chncaesar/stm32_vehicle/docs/L298N驱动板功能图.jpg

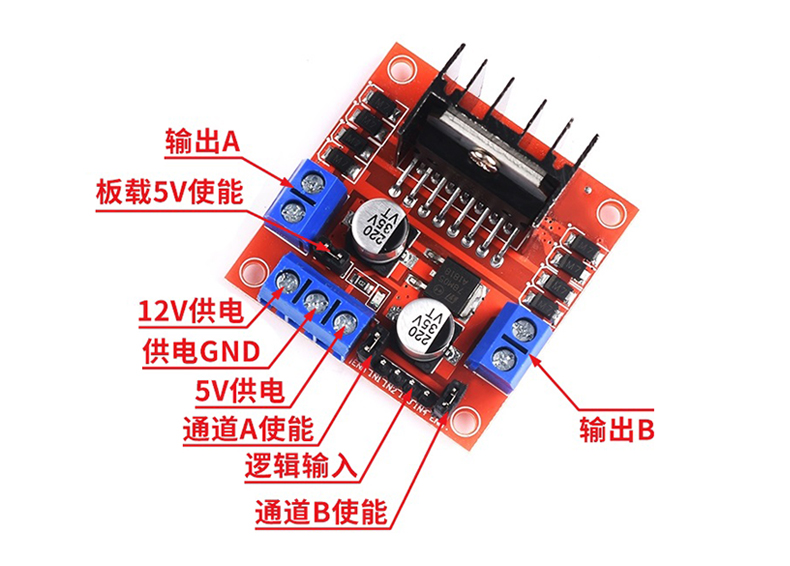
docs/L298N驱动板功能图.jpg
