chncaesar/stm32_vehicle/docs/ch340g.jpg

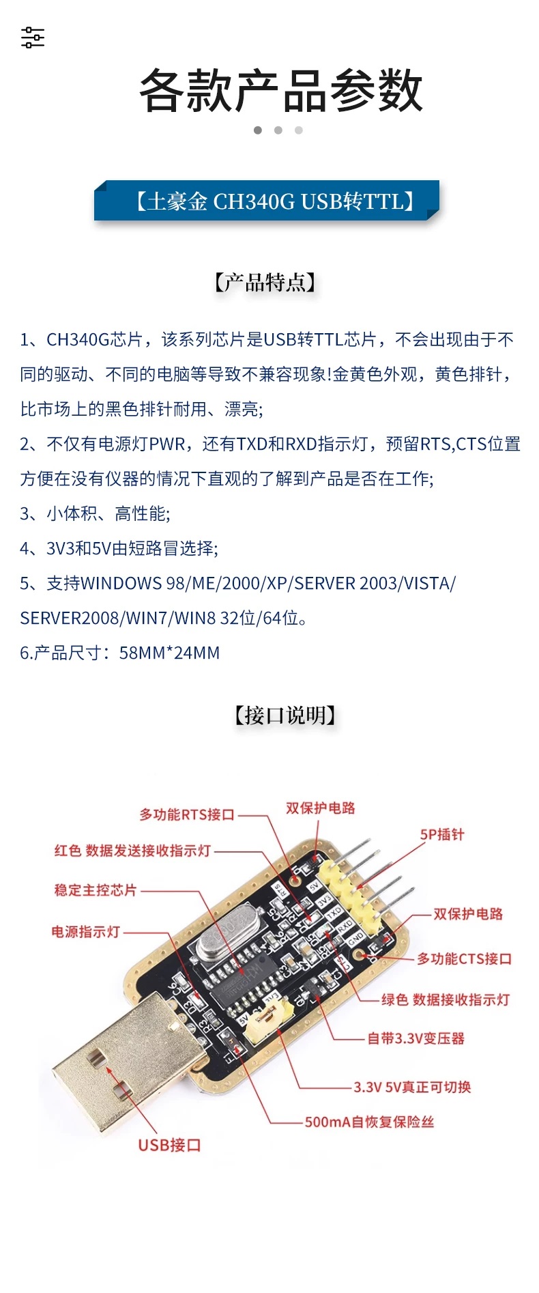
docs/ch340g.jpg
