chncaesar/stm32_vehicle/docs/STM32F103RCT6控制板1-PCB.png

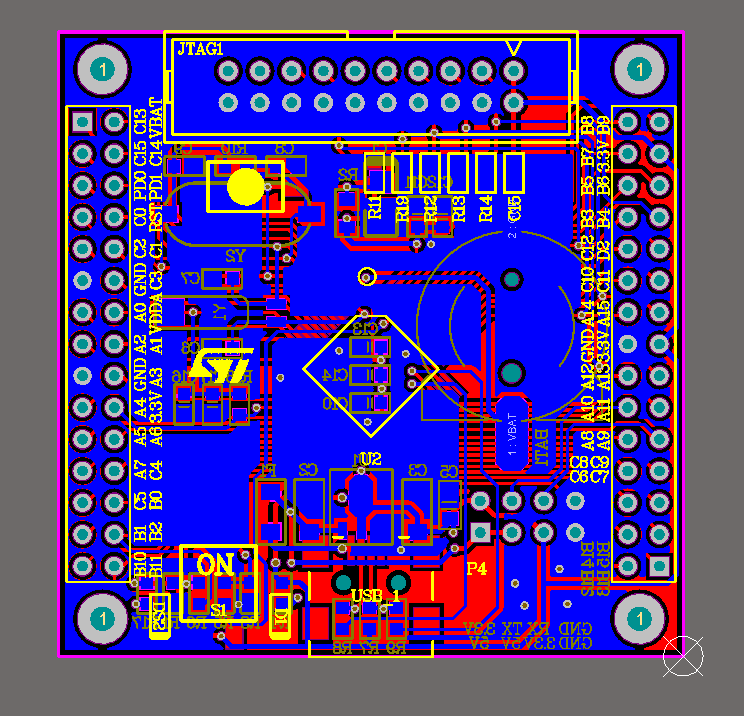
docs/STM32F103RCT6控制板1-PCB.png
