chncaesar/stm32_vehicle/docs/STM32F103RCT6控制板2-PCB.png

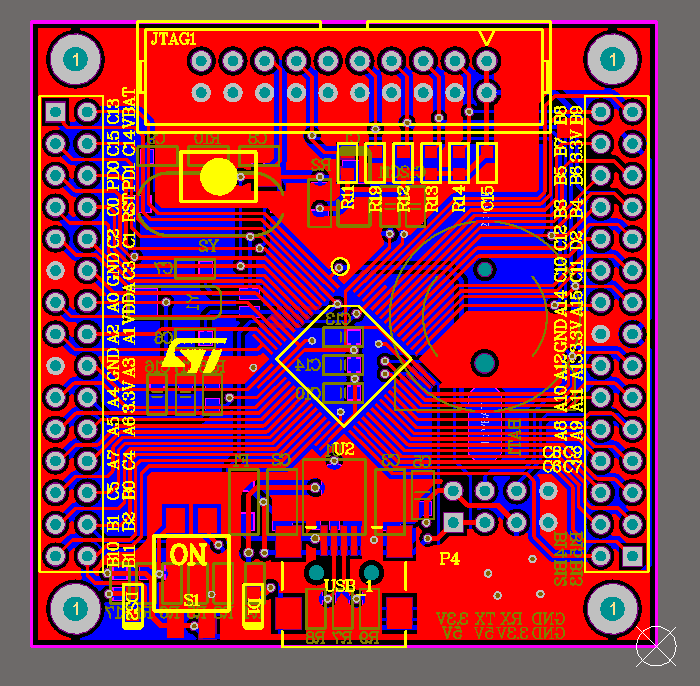
docs/STM32F103RCT6控制板2-PCB.png
