chncaesar/stm32_vehicle/docs/扩展板PCB.png

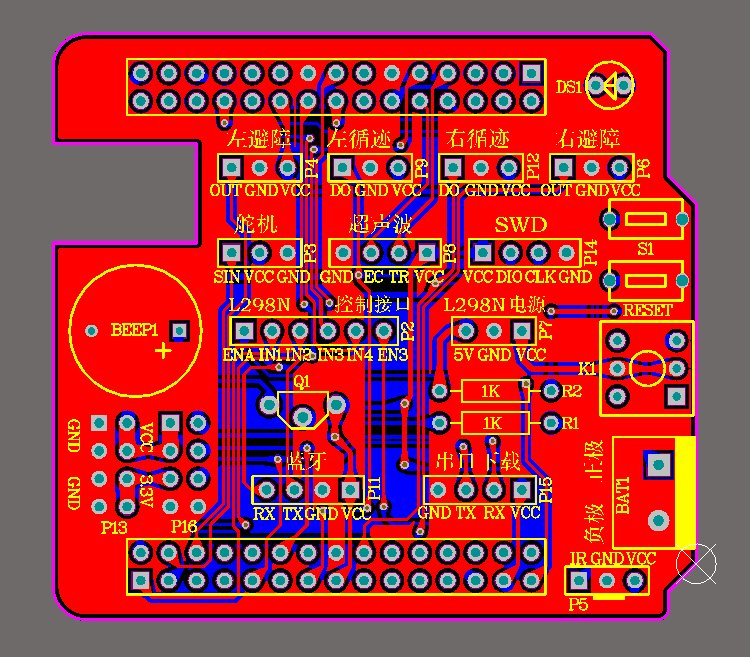
docs/扩展板PCB.png
