chncaesar/stm32_vehicle/docs/扩展板原理图.png

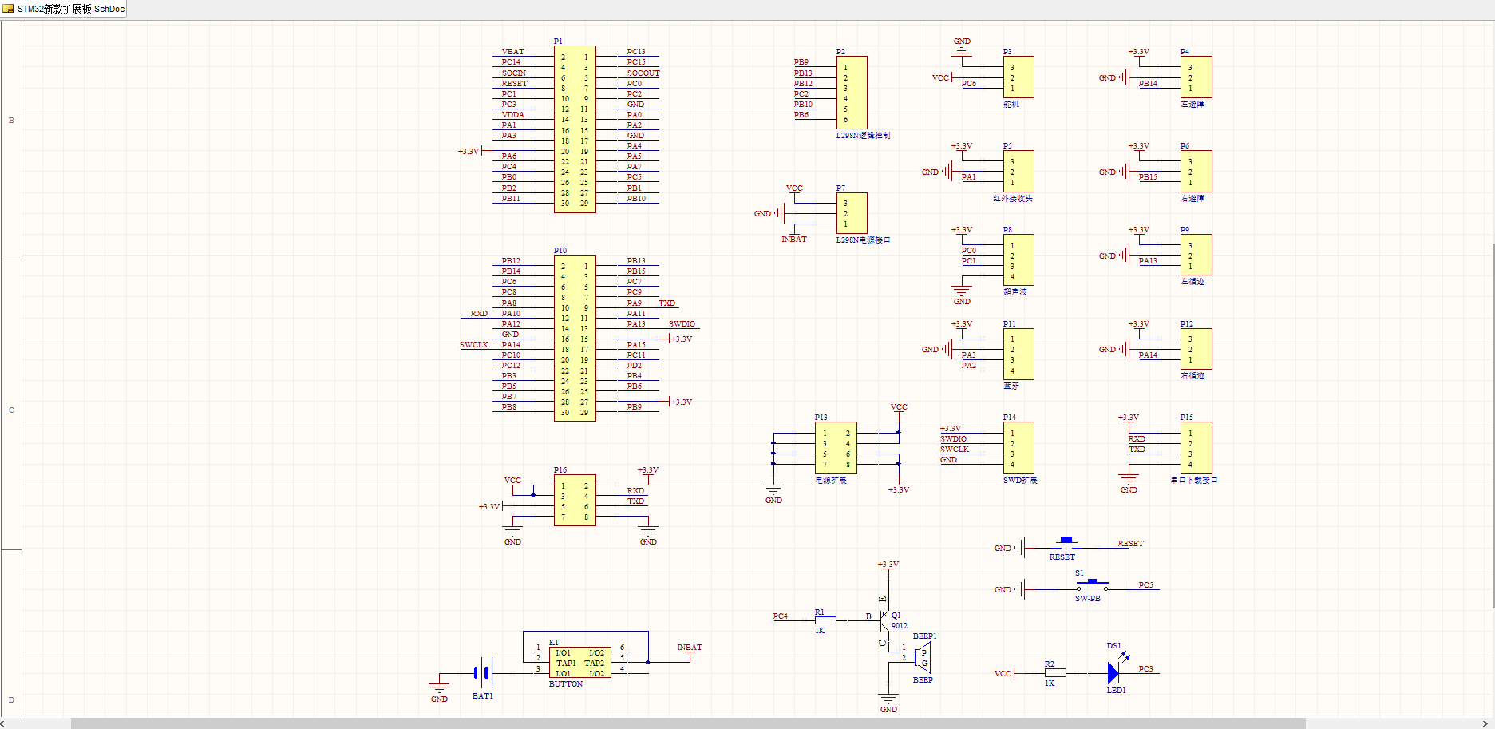
docs/扩展板原理图.png
