chncaesar/stm32_vehicle/docs/ch340_hm10_wiring.md

# CH340 监听 HM-10 接线方案

只有杜邦线的情况下，"并联"在物理上其实是把**三个端点连到同一个电气节点**：HM-10 TXD、P16 pin 3、CH340 RXD。下面给出三种可行做法。

---

## 方法 A：双母头叠插同一根公针（最快，无需破坏线）

杜邦母头是金属簧片夹紧公针。**如果簧片够松、公针够长**，可以把两个母头同时塞进同一根公针上。

### 操作步骤

1. HM-10 模块的 TXD 引脚是公针（朝上凸出）
2. 把第一根母-母杜邦线的一头插上去（另一头去 P16 pin 3）
3. 把第二根母-母杜邦线的一头**叠插**在同一根公针上（另一头去 CH340 RXD）

### 成功率

看簧片松紧。挤进去后用手指晃晃，不掉就行。如果太紧塞不进去，或一推就掉，换方法 B。

---

## 方法 B：剥皮拧接（最稳，但破坏一根线）

### 操作步骤

1. 选 1 根母-母杜邦线，量好够长，从中间剪断
2. 把剪断的两个端面各剥出 5mm 铜丝
3. 再剥一根杜邦线某一头的铜丝
4. 三根铜丝拧在一起（捏紧、绕几圈）
5. 用电工胶带或热缩管包好，避免短路

### 接法

- 杜邦线 A1（HM-10 TXD 端）→ 拧接点 → 杜邦线 A2（P16 pin 3 端）
- 拧接点 → 杜邦线 B（CH340 RXD 端）

### 缺点

这根线就半永久改装了。调试完想还原，重新焊回或者换新线即可。

---

## 方法 C：换一种思路——只接 CH340，先不接 STM32（推荐）

调试阶段可以**临时把 HM-10 从 P16 上拔下来**，让它只跟 CH340 配对，看 iOS App 发出的字节。这样不需要并联。

### 接线

| HM-10 | CH340 | 说明 |
|---|---|---|
| VCC | 3V3 | 这次允许，因为 HM-10 不再连扩展板，电源不冲突 |
| GND | GND | 共地 |
| TXD | RXD | 看 iOS 发来的字节 |
| RXD | （不接） | 只看 iOS 发的，不需要往 iOS 回发 |

### 优点

- 最干净的方案
- HM-10 通过 CH340 直接挂在电脑上，SSCOM 能看到 iOS 发来的所有字节
- 验证完蓝牙链路再把 HM-10 接回 P16

### 代价

验证时小车不会动（因为 HM-10 没接到 STM32），但本步要看的就是"App 发的字节对不对"，这个目的能达到。

---

## 三个方法对比

| 方法 | 难度 | 可靠性 | 联调 | 推荐度 |
|---|---|---|---|---|
| A 叠插 | 低 | 看运气 | 是 | ★★ |
| B 剥皮拧接 | 中 | 高 | 是 | ★★★ |
| C 单独接 | 低 | 高 | 否 | ★★★★ |
