chncaesar/stm32_vehicle/SYSTEM/usart/usart.h

#ifndef __USART_H
#define __USART_H
#include "stdio.h"	
#include "sys.h" 












#define USART_REC_LEN  			200
#define EN_USART1_RX 			1
	  	
extern u8  USART_RX_BUF[USART_REC_LEN];
extern volatile u16 USART_RX_STA;
// === 调试用（排查完删除）===
extern volatile u32 dbg_isr_count, dbg_rxne_count, dbg_err_count;
extern volatile u8  dbg_last_byte;
extern volatile u16 dbg_last_sr;

void uart_init(u32 bound);
#endif
