chncaesar/stm32_vehicle/(commit log)

2026-05-10 Initial commit: STM32 smart car firmware
    - Three driving modes: forward, line tracking, obstacle avoidance
    - Obstacle avoidance: alternating turn direction when both sides blocked
    - Motor drive comments rewritten (removed garbled encoding)
    - Default mode set to obstacle avoidance (mode 2)
    - Added CLAUDE.md with architecture and logic documentation
    [key.c, key.h, led.c]
2026-05-16 添加蓝牙遥控设计文档及更新 .gitignore
    - 新增 docs/bluetooth_remote_design.md：硬件选型、接线、协议、固件设计
    - 新增 docs/bluetooth_remote_review.md：代码 review 检查点
    - 新增 docs/project_context.md：项目上下文，供双平台开发同步
    - .gitignore 新增 USER/*.uvoptx 和 .claude/
2026-05-16 CLAUDE.md 引用 docs/project_context.md
2026-05-16 实现蓝牙遥控固件，删除循迹和避障模块
    - motor_drive: 去掉所有运动函数的 time 参数和 delay_ms 阻塞，改为立即返回
    - main.c: 重写为蓝牙遥控模式，解析 ONA/ONB/ONC/OND/ONE/ONF/ON1-9 指令
    - 新增断连超时检测（主循环计数，约500ms无数据自动停车）
    - uart_init 改为 9600 波特率匹配 HM-10 默认值
    - 删除 tracking.c/h 和 obstacle_avoidance.c/h
    - uvoptx 从 git 追踪中移除
2026-05-16 iOS 遥控 App 实现：BLE 通信 + 方向/速度控制 + 单元测试
    - BLEManager: HM-10 扫描/连接/重连/指令发送，支持 State Restoration
    - CarControlViewModel: 方向/速度业务逻辑，后台自动停车
    - 四方向方向盘 + 速度滑块 UI 组件
    - ConnectionView: 设备扫描列表，RSSI 显示，权限引导
    - 单元测试覆盖指令编码、ViewModel 状态流转、Mock BLE
2026-05-24 修复蓝牙遥控两处严重 Bug
    1. USART_RX_STA 加 volatile，防止编译器缓存导致主循环看不到 ISR 更新
    2. 断连超时改用 SysTick 毫秒计时（bt_tick），替换原来约 5ms 就触发的循环计数器，超时阈值 500ms
    [main.c, usart.c, usart.h]
2026-05-24 更新文档：iOS App 开发完成
    - 标记 iOS 遥控 App 开发任务为完成
    - 更新 project_context.md 待办事项
    - 更新 bluetooth_remote_design.md，添加 iOS App 实现章节
    - 新增 ios_app_guide.md，包含项目结构、快速开始、模块说明、调试技巧
2026-05-24 修复两处 SysTick 严重 Bug
    1. 删除 stm32f10x_it.c 中的空 SysTick_Handler，消除与
    main.c 的重复定义，修复链接错误。
    2. led_beep_switch() 内部调用 delay_ms() 会关闭 SysTick，
    导致 bt_tick 停止计数、超时停车失效。在 led_beep_switch()
    之后重新配置 SysTick 1ms 中断，再初始化 last_rx_tick。
    [main.c]
2026-05-24 更新 CLAUDE.md，新增 README.md
    - CLAUDE.md：同步项目现状（蓝牙遥控单模式），更新架构、
    引脚表、Key Design Decisions；记录 delay_ms 破坏 SysTick
    时钟源的已知陷阱；删除已移除的避障逻辑描述；引用原理图
    - README.md：新增面向用户的使用文档（硬件接线、烧录、
    App 安装、操作说明、串口调试、指令协议）
2026-05-24 修复 SysTick 时钟源 Bug
    delay_ms() 非 OS 路径会用 |= 写 SysTick->CTRL，不清除
    CLKSOURCE 位，导致时钟源从 HCLK/8 变为 HCLK（72MHz）。
    两处重新配置 SysTick 前均补加
    SysTick_CLKSourceConfig(SysTick_CLKSource_HCLK_Div8)，
    确保 bt_tick 以正确的 1ms 步进计数，500ms 超时不会误触发。
    [main.c]
2026-06-07 添加调试 printf 输出及蓝牙排查文档
    - main.c: bluetooth_cmd_parse() 添加 UART 调试输出，用于 CH340 串口监控
    - docs/ch340_hm10_wiring.md: CH340 监听 HM-10 的三种接线方案
    - docs/troubleshooting_bluetooth.md: 蓝牙遥控故障完整排查记录
2026-06-07 添加 CH340 数据手册及模块照片
2026-06-13 添加 USART 接收调试计数器
    在 ISR 中统计中断次数、RXNE 字节数、错误标志，主循环每秒打印一次，
    用于排查 HM-10 信号是否到达 PA10（区分硬件接触问题与固件问题）。
    [main.c, usart.c, usart.h]
2026-06-14 调试用：超时延长至 10 分钟，去掉开机 boot 日志
    排查电机不动问题：将 BT_TIMEOUT_MS 临时改为 600000，单发一次指令
    即可持续运行 10 分钟，方便万用表测量 L298N 各点电压。去掉开机
    boot 打印以避免经 HM-10 回显造成 RX 自激。排查完需改回 500。
    [main.c]
2026-06-14 添加项目文档与工具
    新扩展板 PCB 图、L298N 驱动板资料、CH340 数据手册、蓝牙排查记录、
    iOS App 设计文档等，以及一个 doc 读取工具脚本。
